peno64/ChickenGuard/Connections.jpg

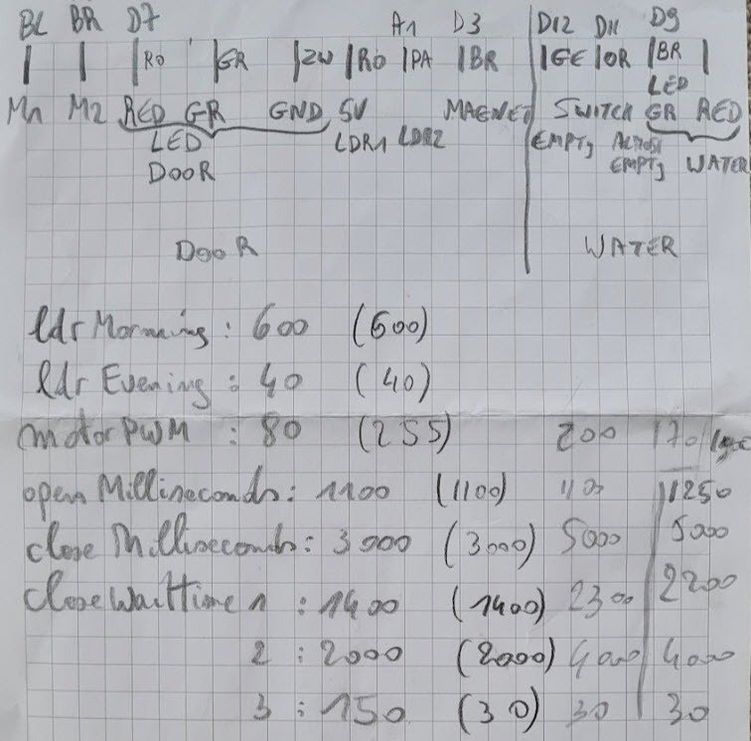
Connections.jpg
