peno64/ChickenGuard/html/CableWinderMotor.jpg

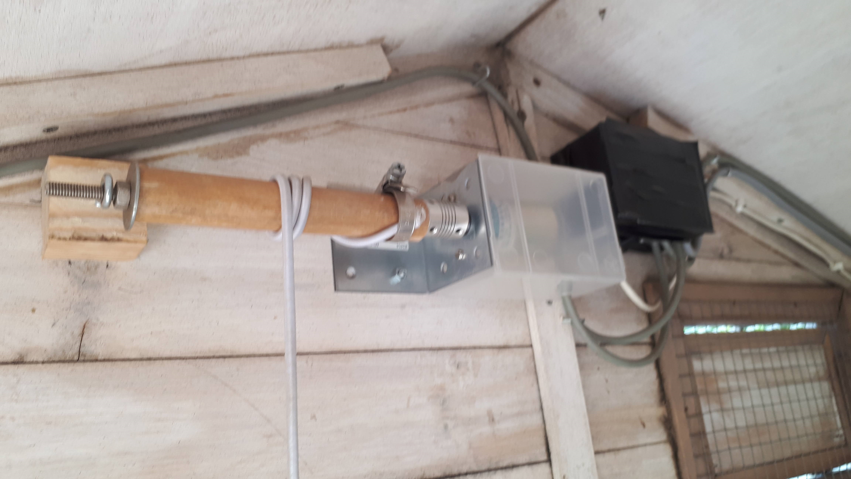
html/CableWinderMotor.jpg
