peno64/ChickenGuard/html/DoorClosedOutside.jpg

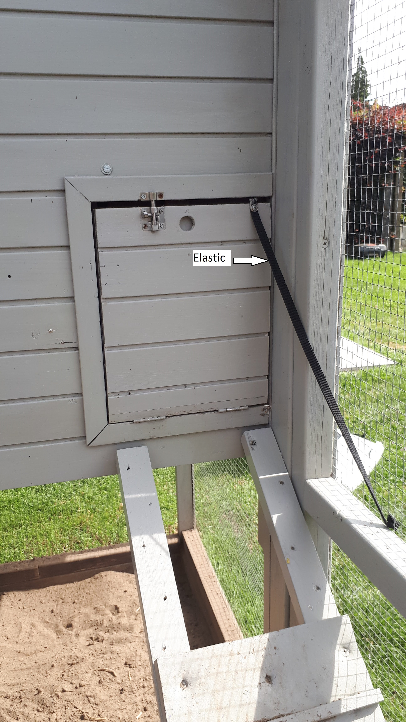
html/DoorClosedOutside.jpg
