peno64/ChickenGuard/html/DoorOpenInside.jpg

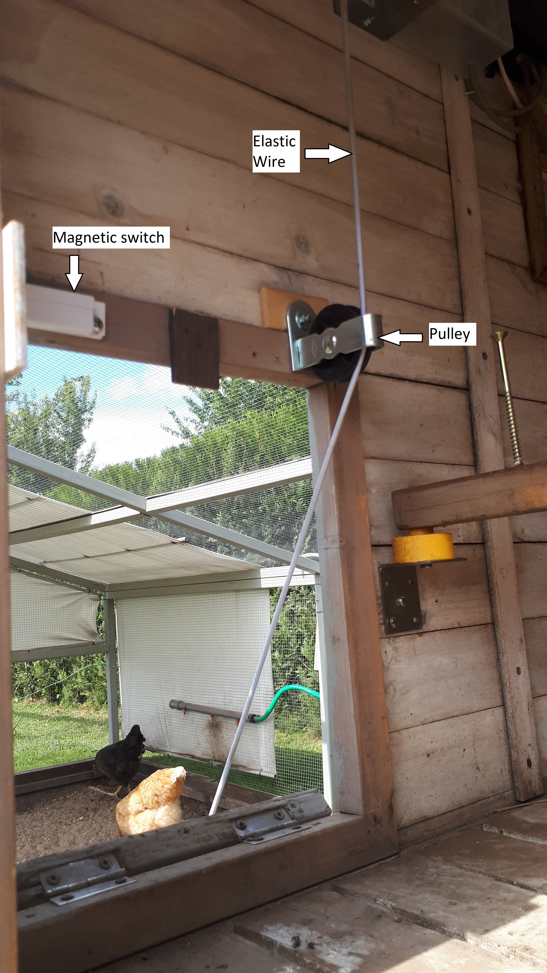
html/DoorOpenInside.jpg
