peno64/ChickenGuard/html/DoorOpenOutside.jpg

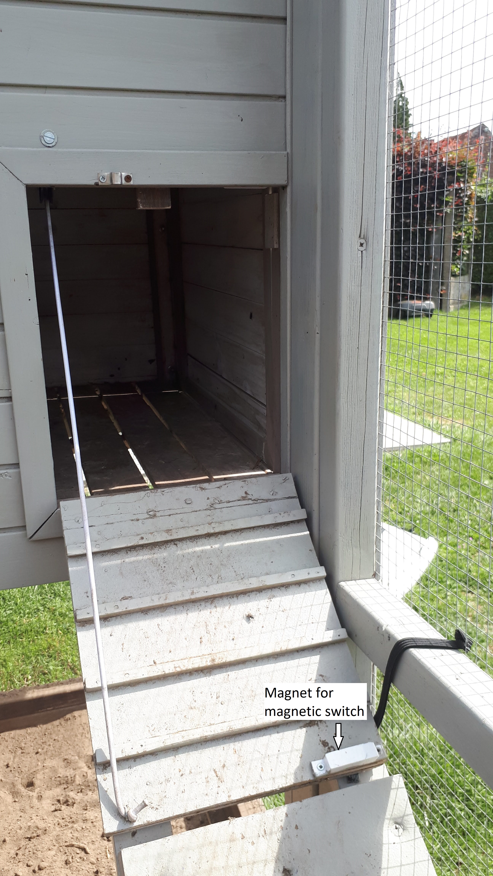
html/DoorOpenOutside.jpg
