peno64/ChickenGuard/html/Electronics.jpg

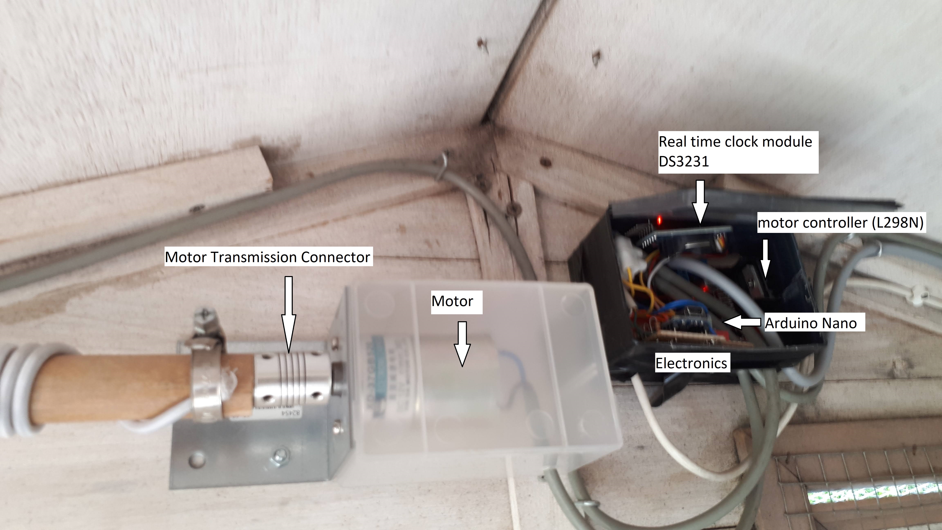
html/Electronics.jpg
