peno64/ChickenGuard/html/Green (Closed) Led.jpg

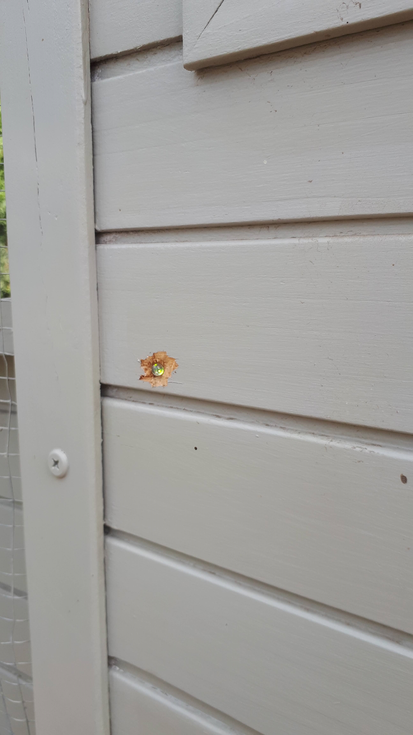
html/Green (Closed) Led.jpg
