peno64/ChickenGuard/html/Mechanics.jpg

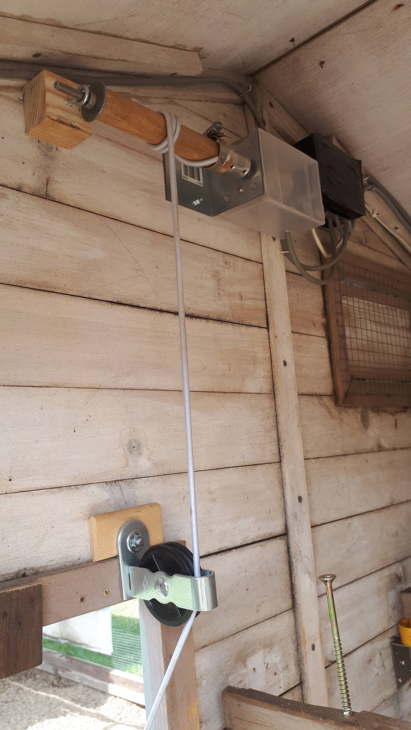
html/Mechanics.jpg
