peno64/ChickenGuard/html/Red (Open) Led.jpg

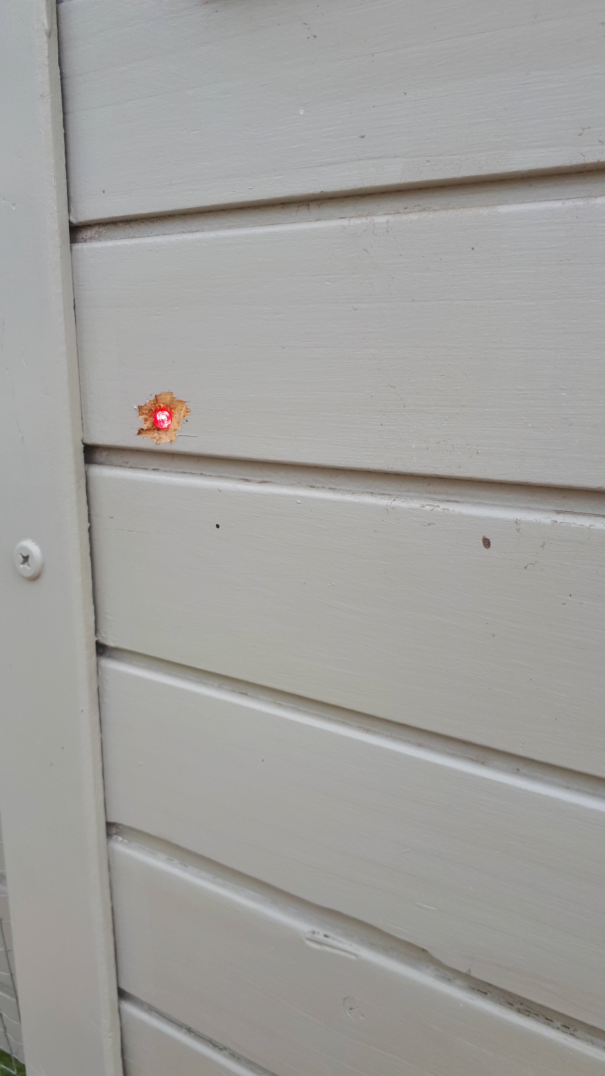
html/Red (Open) Led.jpg
