peno64/ChickenGuard/html/Schema.png

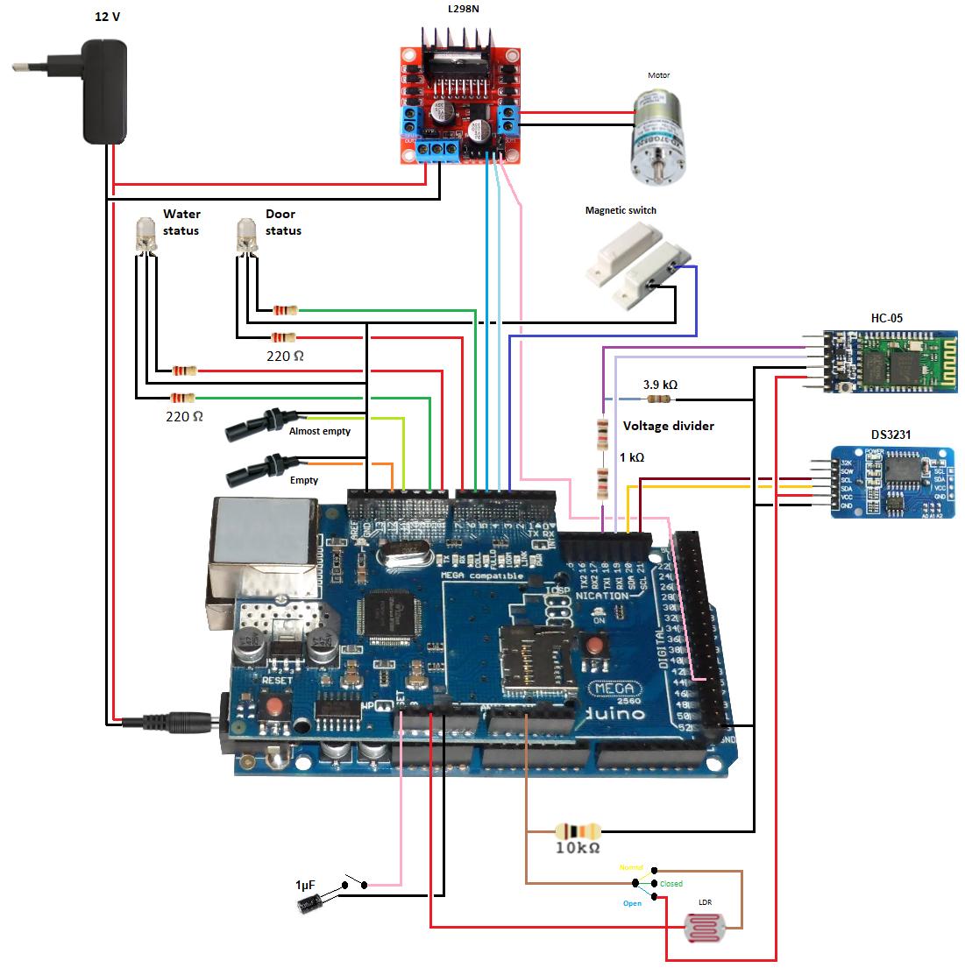
html/Schema.png
