peno64/ChickenGuard/html/SchemaNano.png

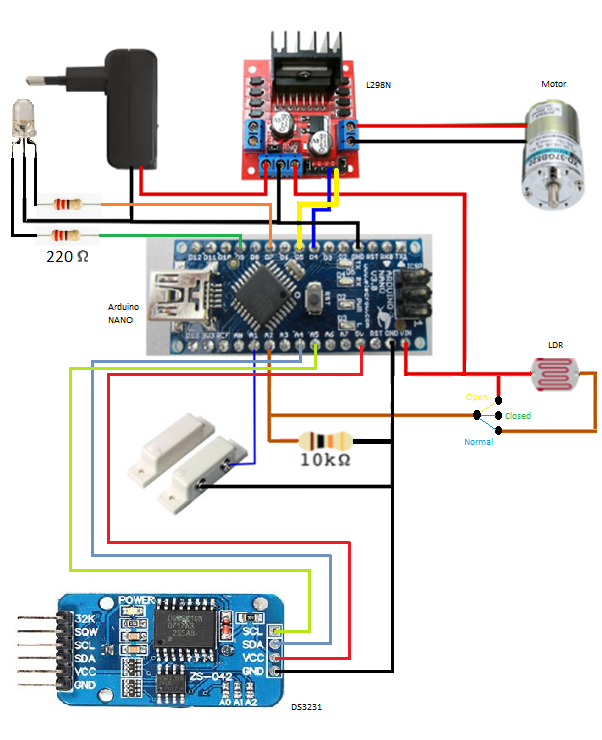
html/SchemaNano.png
