peno64/ChickenGuard/html/Automatisch kippenluikje zelf maken - techniek en dier_files/automatisch_kippenluik.jpg

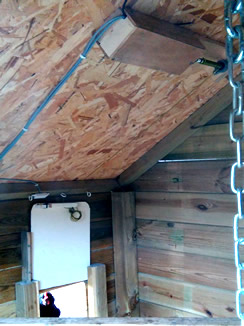
html/Automatisch kippenluikje zelf maken - techniek en dier_files/automatisch_kippenluik.jpg
