peno64/ChickenGuard/html/Automatisch kippenluikje zelf maken - techniek en dier_files/controller.jpg

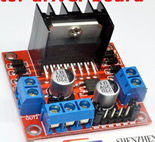
html/Automatisch kippenluikje zelf maken - techniek en dier_files/controller.jpg
