peno64/ChickenGuard/html/Automatisch kippenluikje zelf maken - techniek en dier_files/deur.jpg

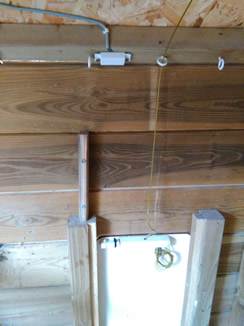
html/Automatisch kippenluikje zelf maken - techniek en dier_files/deur.jpg
