peno64/ChickenGuard/html/Automatisch kippenluikje zelf maken - techniek en dier_files/kippenluikschema.png

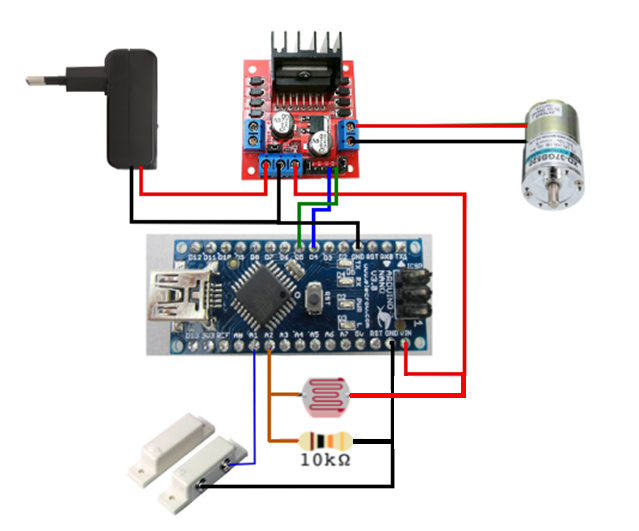
html/Automatisch kippenluikje zelf maken - techniek en dier_files/kippenluikschema.png
