peno64/ChickenGuard/html/Automatisch kippenluikje zelf maken - techniek en dier_files/lichtsensor.jpg

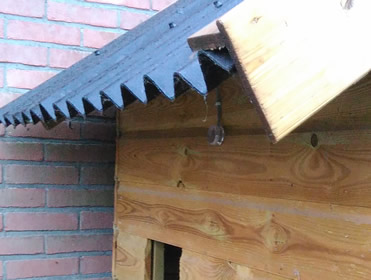
html/Automatisch kippenluikje zelf maken - techniek en dier_files/lichtsensor.jpg
