peno64/ChickenGuard/html/Automatisch kippenluikje zelf maken - techniek en dier_files/takel.jpg

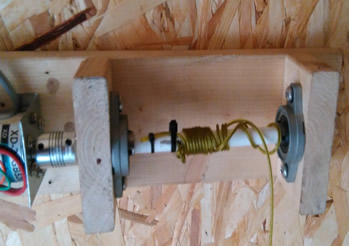
html/Automatisch kippenluikje zelf maken - techniek en dier_files/takel.jpg
