peno64/ChickenGuard/(threads)

Thread 1 (2023-12-03):

Changes for new version

peno64, 2023-12-03:
- Use Arduino mega

- Use slower motor

- Connect arduino with an ethernet shield which communicates via MQTT with Home Assistant
   - Close door a bit sooner (light) and maybe also one hour after sunset
   - Information like door open/closed
   - Error status
   - Date/Time (get & set)
   - Temperature (get)
   - Open/Close door remotely pwd protected
   - Execute all functions that can be done via terminal
   - Reset error

- Show water status
   - Almost empty
   - Really empty

- In HA report if still open after sunset + 1 hour
- In HA report error via mail

Closed 2024-02-04.
