peno64/ChickenGuard/(commit log)

2020-10-25 It was no longer possible to set the date/time (close door reacted)
    [ChickenGuard.ino]
2020-11-13 set timeout on input, green led on error & fix compilation warnings
    [ChickenGuard.ino]
2021-01-18 - Night check that hatch auto closes when trying to open it didn't work anymore - Disable arduino clock code if a clock module is attached to save memory
    [ChickenGuard.ino]
2021-01-26 Show extra time information when a problem occured
    [ChickenGuard.ino]
2021-02-06 Make it possible to immediately open and close the door via a switch on the LDR
2024-04-09 fixes on sync date/time
    [ChickenGuard.ino]
2024-06-15 ESP32 support
